hww/makerlisp/docs/bom/ioexp_bom.pdf

IOEXP BOM

Page 1

Designator | Description | Manufacturer | Manufacturer Part Number | Supplier Supplier Part Number | Quantity
| CONN JUMPER SHORTING GOLD FLASH | | SPC02SYAN | S9001-ND | 2
C13 | CAP CER 1UF 16V X7R 0603 | | CL10B105MO8NNWC | 1276-6524-1-ND | 1
C1,C5 | CAP CER 0.1UF 16V Y5V 0603 | | CL10F104ZO8NNNC | 1276-1258-1-ND | 2
C2,C4 | CAP CER 10UF 16V X5R 0805 | | CL21A106KOFNNNE | 1276-2893-1-ND | 2
C3 | CAP CER 0.33UF 35V X5R 0603 | TDK Corporation | CGA3E3X5R1V334M080AB | 445-12479-1-ND | 1
CN1 | CONN HEADER 120POS W/POST SMD | | FX10A-120S/12-SV1(71) | H11234-ND | 1
D1 | LED RED CLEAR CHIP SMD | Lite-On Inc. | LTST-C193KRKT-5A | 160-1830-1-ND | 1
D2 | LED BLUE CLEAR CHIP SMD | Lite-On Inc. | LTST-C193TBKT-5A | 160-1827-1-ND | 1
IC1 | IC INVERTER 1CH 1-INP SC70-5 | Texas Instruments | SN74LVC1G04DCKR | 296-11600-1-ND | 1
J8,J10 | CONN HEADER .100 SNGL STR 16POS | | PREC016SAAN-RC | S1012EC-16-ND | 2
J1-J2,J6-J7 | CONN HEADER .100 SNGL STR 2POS | | PREC002SAAN-RC | S1012EC-02-ND | 4
J3-J4 | CONN HEADER .100 SNGL STR 3POS | | PREC003SAAN-RC | S1012EC-03-ND | 2
J5 | CONN PWR JACK 2X5.5MM SOLDER | CUI Inc. | PJ-002AH-SMT-TR | CP-002AHPJCT-ND | 1
J9 | DIL VERTICAL PC TAIL PIN HEADER | | M20-9980346 | 952-2121-ND | 1
R5-R6,R8,R10 RES SMD 10K OHM 5% 1/4W 0603 | ESR03EZPJ103 | RHM10KDCT-ND | 4
R1,R3-R4,R9 | RES SMD 1K OHM 5% 1/4W 0603 | | ESR03EZPJ102 | RHM1.0KDCT-ND | 4
R2 | RES SMD 100K OHM 5% 1/4W 0603 | | ESR03EZPJ104 | RHM100KDCT-ND | 1
U10 | IC PWR SW USB SOT25 | | XC8107AC20MR-G | Mouser 865-XC8107AC20MR-G | 1
U1 | IC REG LIN 5V 1.5A DDPAK/TO263-3 | Texas Instruments | UA7805CKTTR | 296-20796-1-ND | 1
U2 | IC REG LINEAR 3.3V 1A SOT223-3 | Microchip Technology | MCP1826ST-3302E/DB | MCP1826ST-3302E/DBCT-ND | 1
Sullins Connector Solutions | Digi-Key
Samsung Electro-Mechanics | Digi-Key
Samsung Electro-Mechanics | Digi-Key
Samsung Electro-Mechanics | Digi-Key
| Digi-Key
Hirose Electric | Digi-Key
| Digi-Key
| Digi-Key
| Digi-Key
Sullins Connector Solutions | Digi-Key
Sullins Connector Solutions | Digi-Key
Sullins Connector Solutions | Digi-Key
| Digi-Key
Harwin Inc. | Digi-Key
Rohm Semiconductor | Digi-Key
Rohm Semiconductor | Digi-Key
Rohm Semiconductor | Digi-Key
Torex Semiconductor
| Digi-Key
| Digi-Key

IOEXP BOM

Page 2

DNP Comment
