hww/makerlisp/docs/bom/usb_bom.pdf

USB BOM

Page 1

Designator Description | Manufacturer | Manufacturer Part Number | Supplier Supplier Part Number | Quantity
C1,C6-C7 10uF 6.3V 0603 MLCC capacitor | CL10A106MQ8NNNC | 1276-1119-1-ND | 3
C2,C4 | 18pF 0603 MLCC capacitor | | C0603C180K5GACTU | 399-7866-1-ND | 2
C3,C5,C8 0.1uF 6.3V 0603 MLCC capacitor | CL05B104KQ5NNNC | 1276-1511-1-ND | 3
C9 | 1uF 6.3V 0603 MLCC capacitor | | CL10A105KQ8NNNC | 1276-1036-1-ND | 1
D1 | Red LED 1005 metric | Stanley Electric Co | FHR1105P-TR | 404-1211-1-ND | 1
D2 | Amber LED 1005 metric | Stanley Electric Co | FHA1105P-TR | 404-1210-1-ND | 1
J1 | CONN USB RECEPT R/A TYPE A 4POS TE Connectivity AMP Connectors 292303-1 | A31726-ND | 1
J2 | 0.1 header 6 position ICSP | | 61300611121 | 732-5319-ND | 1
J3 | 0.1 header 4 position | | 61300411121 | 732-5317-ND | 1
R1 | 10k 0603 resistor | Panasonic | ERJ-3GEYJ103V | P10KGCT-ND | 1
R2 | 1k 0603 resistor | Panasonic | ERJ-3GEYJ102V | P1.0KGCT-ND | 1
R3 | 330 0603 resistor | Panasonic | ERJ-3GEYJ331V | P330GCT-ND | 1
S1 | Small push-button switch oval | E-Switch | TL3365AF180QG | EG5384CT-ND | 1
U2 | Regulator | Microchip | MCP1700T-3302E/TT | MCP1700T3302ETTCT-ND | 1
U1 | MCU | Microchip | PIC32MM0064GPM028T-I/SS | PIC32MM0064GPM028T-I/SSCT-ND | 1
Y1 | 8 MHz crystal 20ppm 4-SMD | | ABM3B-8.000MHZ-B2-T | 535-9720-1-ND | 1
Samsung Electro-Mechanics | Digi-Key
Kemet | Digi-Key
Samsung Electro-Mechanics | Digi-Key
Samsung Electro-Mechanics | Digi-Key
| Digi-Key
| Digi-Key
| Digi-Key
Wurth Electronics Inc. | Digi-Key
Wurth Electronics Inc. | Digi-Key
| Digi-Key
| Digi-Key
| Digi-Key
| Digi-Key
| Digi-Key
| Digi-Key
Abracon LLC | Digi-Key

USB BOM

Page 2

DNP Comment
