hww/makerlisp/docs/manuals/mlmswref.rtf

MakerLisp Machine Software Reference

This document is not complete. For now it serves to highlight some important differences between MakerLisp and other Lisp dialects, and gives a list of supported forms.

1. The reader

The reader returns a value as soon as a complete expression is acquired. This means, in the read-evaluate-print loop, a delimiting or ending character typed by the user will cause the expression to be returned to the reader, evaluated, and printed, immediately, without the necessity of ending the line explicitly, by entering a carriage return. This may be surprising, at first. Type "()" to see a simple example. But it also means that you can end complex expressions by typing right parentheses until the expression is accepted - when it is accepted, the reader will print a newline and then pass the expression to the evaluator.

There are no strings in MakerLisp, there are only symbols. As in Scheme, symbols have no properties, only a name. In MakerLisp there are no rules about what character strings can be the name of a symbol, but the reader uses conventional cues about what is likely a number, what is a list, and what is a vector, assuming that anything else is a symbol. These cues can be overridden with ' \ ' (escape, or take literally, as a part of a symbol name, the next character), and ' " ' (assume all characters enclosed by the double quotes are to be taken literally as part of a symbol name).

Where one would use a string, which is a constant, in other Lisps, in MakerLisp, a quoted symbol name is used. For example, instead of "This is a string" typed in the REPL , returning the string as the value, type '"This is a symbol", to get that symbol as the value.

To return a symbol with the name "123", type "123". Or "1 unusual symbol". Symbols can have any name, but the reader will make the ordinary guesses it would make in any Lisp, unless you help it out when there are unusual characters (characters that make a symbol name look like a number, list, or a vector).

2. The path, and auto-loading

When the environment is searched for a binding for a variable, if none is found, the evaluator checks to see if, somewhere on the path, there is a file named "< symbol name>.l" . If no such file is found, the symbol is unbound and an error is thrown. If a file is found, a stub macro is put in place as the value of the variable. This stub assumes that the symbol is being used as a function or macro name in the first position of an application, and causes that specific file to be loaded, every expression in the file to be evaluated, and then the original application is re-evaluated, this time with the benefit of the re-binding of the symbol according to the loaded file. If the file did in fact define the value of the symbol to be a well-formed function or macro, then execution proceeds as if the symbol had been defined that way before it was used in an application. So it is not neccessary to include or load function or macro definitions before those functions or macros are used, if a properly named file with the function or macro definition is on the path. For example, "demo/hello.l" is in the default filesystem image, and the default path is "/demo:/bin". So typing "(hello)" executes the function defined in "demo/hello.l".

The path exists in two parts: there is a path variable "*PATH*", and as shown above, it contains directory specifications, separated by colons. These directories are searched first. You can set the *PATH* variable to anything you like.

The other part of the path is searched next, and it is not specified by any Lisp variable, it is hard-wired in the MakerLisp system. This built-in set of searched directories are the subdirectories of the "/l" directory. They contain essential language definitions and utility functions.

When the system starts up, it starts by loading "/l/util/makerlisp.l". The last expression in this includes the "/l/user.l" file. user.l defines the *PATH* variable, and prints a start-up message. If you want to change your path, or add to your start-up, this is a good place to do that.

3. List of supported forms

In the following list, for each function, the diectory in which the defining lisp file is given, or if the form is defined by the implementation, "core" is displayed. In the notes column, a brief comment is given if the form is unlike anything in Scheme or Common Lisp.

Form Defined In Notes

call/cc core
define core
if core
lambda core
macro core
progn core
quote core
setq core

_add core dyadic add
_cats core dyadic symbol concatenation
_div core dyadic divide
_equal core dyadic equal
_iand core dyadic integer (bitwise) and
_ior core dyadic integer (bitwise) or
_ixor core dyadic integer (bitwise) exclusive or
_less core dyadic less-than
_mul core dyadic multiply
_sub core dyadic subtract
% core integer modulus
assignedp core
boundp core
car core
cd core change directory
cdr core
commitid core flash rom signature
cons core
debugger core low-level debugger
defer core defer (^C) breaks
eof core skip to end of file in input stream
eq core
orerror core throw an error
eval
forget core forget (unbind) top-level variable
gensym core
ffcall core foreign function call
inclevel core current input stream include level
include core include a file in input stream
int2real core convert integer to real
int2sym core convert integer to 1 character symbol
integerp core
keyp core keypress at UART 0/TTY
list core
list2vector core convert list to vector
ls core current directory listing
not core
pairp core
print core
quit core stop, show statistics
read core
readreg core read I/O register
real2int core convert real to integer
realp core
rplaca core
rplacd core
setetop core get rest after/truncate-to mark in env
sym2int core convert symbol first character to integer
symbolp core
vectorp core
verbose core verbosity (include level display) in REPL
vlen core vector length
vref core vector element reference
vset core vector element store
writereg core write I/O register
zerop core
~ core integer (bitwise) complement
>> core integer arithmetic shift right
<< core integer shift left

atoi l/clib
ceil l/clib
fclose l/clib
fgetc l/clib
floor l/clib
fopen l/clib
fputc l/clib
getchar l/clib
isalpha l/clib
isdigit l/clib
isspace l/clib
pow l/clib
putchar l/clib
rewind l/clib
sprintf l/clib
sqrt l/clib
stderr l/clib
stdin l/clib
stdio l/clib
stdout l/clib
toupper l/clib
ungetc l/clib

FLASH_COL l/ez80 eZ80 I/O and GPIO register access
FLASH_DATA l/ez80
FLASH_FDIV l/ez80
FLASH_KEY l/ez80
FLASH_PAGE l/ez80
FLASH_PGCTL l/ez80
FLASH_PROT l/ez80
FLASH_ROW l/ez80
gpin l/ez80
gpout l/ez80
PA_ALT1 l/ez80
PA_ALT2 l/ez80
PA_DDR l/ez80
PA_DR l/ez80
PB_ALT1 l/ez80
PB_ALT2 l/ez80
PB_DDR l/ez80
PB_DR l/ez80
PC_ALT1 l/ez80
PC_ALT2 l/ez80
PC_DDR l/ez80
PC_DR l/ez80
PD_ALT1 l/ez80
PD_ALT2 l/ez80
PD_DDR l/ez80
PD_DR l/ez80
regbclr l/ez80
regbset l/ez80
RTC_CEN l/ez80
RTC_CTRL l/ez80
RTC_DOM l/ez80
RTC_DOW l/ez80
RTC_HRS l/ez80
RTC_MIN l/ez80
RTC_MON l/ez80
RTC_SEC l/ez80
RTC_YR l/ez80

add l/lang variadic add
and l/lang variadic logical and
append l/lang
apply l/lang
arithmetc l/lang (+,-,*,/, etc.)
assoc l/lang
assq l/lang
atom l/lang
backquote l/lang quasiquote
caaaar l/lang
caaadr l/lang
caaar l/lang
caadar l/lang
caaddr l/lang
caadr l/lang
caar l/lang
cadaar l/lang
cadadr l/lang
cadar l/lang
caddar l/lang
cadddr l/lang
caddr l/lang
cadr l/lang
case l/lang
cats l/lang variablic symbol concatenation
cdaaar l/lang
cdaadr l/lang
cdaar l/lang
cdadar l/lang
cdaddr l/lang
cdadr l/lang
cdar l/lang
cddaar l/lang
cddadr l/lang
cddar l/lang
cdddar l/lang
cddddr l/lang
cdddr l/lang
cddr l/lang
cond l/lang
constant l/lang make constant from expression
div l/lang variadic divide
eql l/lang
equal l/lang
for l/lang
global l/lang bind in top environment
_greater l/lang dyadic greater-than
greater l/lang variadic greater-than
_greaterorequal
l/lang dyadic greater-than or equal
greaterorequal
l/lang variadic greater-than or equal
iand l/lang variadic integer (bitwise) and
ior l/lang variadic integer (bitwise) and
ixor l/lang variadic integer (bitwise) exclusive or
_land l/lang dyadic logical and
length l/lang
less l/lang variadic less-than
_lessorequal
l/lang dyadic less-than or equal
lessorequal l/lang variadic less-than or equal
let l/lang
lets l/lang let-sequential (let*)
listp l/lang
_lor l/lang dyadic logical or
mul l/lang variadic multiply
n-ary l/lang supports variadic functions
nlprint l/lang print, follow with newline
nth l/lang
null l/lang
numberp l/lang true if real or integer
order-nary l/lang supports variadic functions
or l/lang variadic logical or
reverse l/lang
sub l/lang variadic subtract
switch l/lang C-like switch
vector2list l/lang convert vector to list
vector l/lang
while l/lang C-like while

author l/util Show author name and address
debug l/util debug function
discard l/util Swallow expression, return "" symbol
expand l/util Show expression with all macros expanded
import l/util Create load/apply stub for symbol
load l/util load file, evaluate all expressions
makerlisp l/util System start-up
nopatch l/util Turn off JIT and macro patching
patchon l/util Restore JIT and macro patching
repl l/util second-level REPL
trace l/util trace function or macro
undebug l/util Turn off debugger break on function
untrace l/util Turn off trace of function or macro
user l/util User start-up
version l/util Software version
