hww/makerlisp/docs/manuals/mlmterm.rtf

MakerLisp Machine VGA Display Terminal Emulation

I. Overview

The MakerLisp Machine terminal emulates a compatible subset of the DEC vt5xx (vt510, vt520, or vt525) series of ANSI terminals, operating in SCO Unix Console emulation mode, with newline mode on.

There are two parts to the MakerLisp VGA terminal - the USB keyboard controller, and the VGA display controller.

The USB keyboard controller sends out ASCII character sequences from keyboard activity, like the DEC vt5xx terminals in SCO/newline mode, except that:

1) The "Alt" modifier key is ignored
2) "Ctrl" in combination with shifted or unshifted F1-F12, has no effect
3) The editing keys (except for forward delete), Prnt Scrn, Scroll Lock, and Pause/Break, have no effect.

These key events will be supported in a future release.

The VGA display controller's terminal emulator uses X-ON/X-OFF flow control, to keep the MakerLisp Machine CPU from overrunning the terminal emulator's 256 character buffer. This flow control is on all the time.

II. ANSI Terminal Emulator

The terminal emulator supports a very small subset of vt5xx ANSI escape sequence commands, listed below, as well as a few other ANSI-like, but specific to the MakerLisp Machine, escape sequences. Some of the MakerLisp-specific commands have different effects in different display modes (see section III below).

A more capable subset of vt5xx-compatible escape sequences will be implemented in a future release.

vt5xx-compatible ANSI commands ('\e' is "escape", ASCII 27 decimal):

\e[2J Clear screen
\e[p1;p2H Position or home cursor

p1 is a line number from 1 to the number of lines in the display, p2 is a column number from 1 to the number of columns in the display. If p1 and p2 are not both provided then the cursor is 'homed' to row 1, column 1. A value of zero in either p1 or p2 is interpreted as a value of 1.

\e[p1A Cursor up
\e[p1B Cursor down
\e[p1C Cursor forward
\e[p1D Cursor backward

p1 is a number of positions to move the cursor, if this parameter is not provided, these comands will move the cursor by one position.

\e[p1;p2; ... pn;m Set Graphics Rendition

p1 ... pn are ASCII decimal numbers, they are separated by semicolons before the 'm' which defines the 'Set Graphics Rendition' command. If no parameters are given, a single parameter of 0 is assumed. The parameters supported are:

0 : Reset to default attributes
1 : Set bright intensity attribute
7 : Set reverse video attribute
22 : Set normal intensity attribute
27 : Set normal (not reverse) video attribute
30 - 37 : Set foregound color 0 - 7
39 : Set default foreground color
40 - 47: Set background color 0 - 7
49 : Set default background color

With these SGR command parameters, it is possible to set all 16 foreground colors (0-7, 8-15 are 'bright' versions of 0-7), all 8 background colors, and the reverse video attribute, with an ANSI compatible command.

\e[20h Enable newline mode
\e[20l Disable newline mode
\e[?25h Enable cursor display
\e[?25l Disable cursor display
\e[?7h Enable auto line-wrap
\e[?7l Disable auto line-wrap

MakerLisp VGA terminal-specific commands:

\ec Insert literal character

'c' is a character to be inserted literally at the cursor position. If 'c' is a character
that would otherwise have terminal control functions, in this instance it will not, the character will be inserted into the display buffer, allowing the code page 437 character cell defined for that value to be displayed. The cursor position is unchanged, it does not automatically advance with this command.

\e[[ Insert literal character '['

Like the \ec command above, to insert the character '['

\e[p1;p2;p3;p4R Keyboard and Display ROM read/write
\e[p1;p2U
\e[p1;p2;p3;p4;p5;p6V
\e[p1;p2;p3;p4;p5;p6;p7;p8W

These commands are used by utilities to read and write the contents of the keyboard controller's flash memory, or the display controller's EEPROM.

\e[X<f><b> Set foreground / background colors

720x480 display mode:

<f> and <b> are binary bytes, the low four bits of <f> are the foreground color index, and the low three bits of <b> are the background color index. The background color is limited to the 8 normal intensity, not 'bright' colors, in the 16 color ANSI palette.

640x480 or 1024x768 display modes:

<f> and <b> are binary bytes, the low four bits of <f> are the foreground color index, and the low four bits of <b> are the background color index, the background color may be a normal intensity or a bright color in the 16 color ANSI palette.

In any display mode, if BOTH <f> and <b> are either 0xFF or 0x00, this signifies the default color combination at palette index 0, 0 (loaded at start-up with gold foreground on black background).

720x480 display mode:

\e[Y<f><b><fc><bc> Load color palette

<f> and <b> are binary bytes, the low four bits of <f> are the foreground color index, and the low three bits of <b> are the background color index, <f> and <b> together indicating one of 128 color palette entries. <fc> is a byte which specifies one of 64 color values, the low six bits being a 2:2:2 r,g,b format, and <bc> is the background color value, in the same format.

640x480 or 1024x768 display modes:

\e[Y<fc><bc> Set direct color

<fc> and <bc> are binary bytes, the low six bits being the color in 2:2:2 r,g,b format.

\e[Z<r> Set reverse video attribute

<r> is a binary byte, the low bit indicating normal (0) or reverse (1) video

III. Display Resolution, Character cells, and Colors

The default display resolution, corresponding to the EEPROM image provided in the SD card filsystem, '/etc/vga720.rom', is 720x480, providing 30, 80 column rows, of 9x16, code page 437 "extended ascii" characters. The ANSI terminal commands described above may be used to set the indicated foreground, background color combinations on any character as it is written at the current cursor position.

This is the default display controller mode, and firmware loaded onboard, for the VGA display controller as it is shipped from MakerLisp. Two other optional sets of firmware are also provided on the SD card filesystem, and the VGA firmware update utilities can be used to load new firmware and change the display mode - see HOWTO/update.txt for instructions on how to do this.

The optional modes/firmware images are:

'/etc/vga640.rom'

Display resolution of 640x480, providing 30, 80 column rows of 8x16 code page 437 characters. Colors are set with the same ANSI commands as in 720x480 mode, but there are some differences, noted above, and when a color combination is set, it applies to the whole row corresponding to the current cursor position. This mode has slightly larger characters and runs at a lower refresh rate, and it may be more usable on some monitors that have trouble with the default 720x480 mode.

'/etc/vga1024.rom'

Colors set as in 640x480 mode, as noted in descriptions of ANSI commands, above. Display resolution of 1024x768, providing 48, 128 column rows of 8x16 code page 437 characters. This mode may be useful for larger monitors, when a larger text display is desired.
