hww/makerlisp/docs/schematic/cpu_sch.pdf

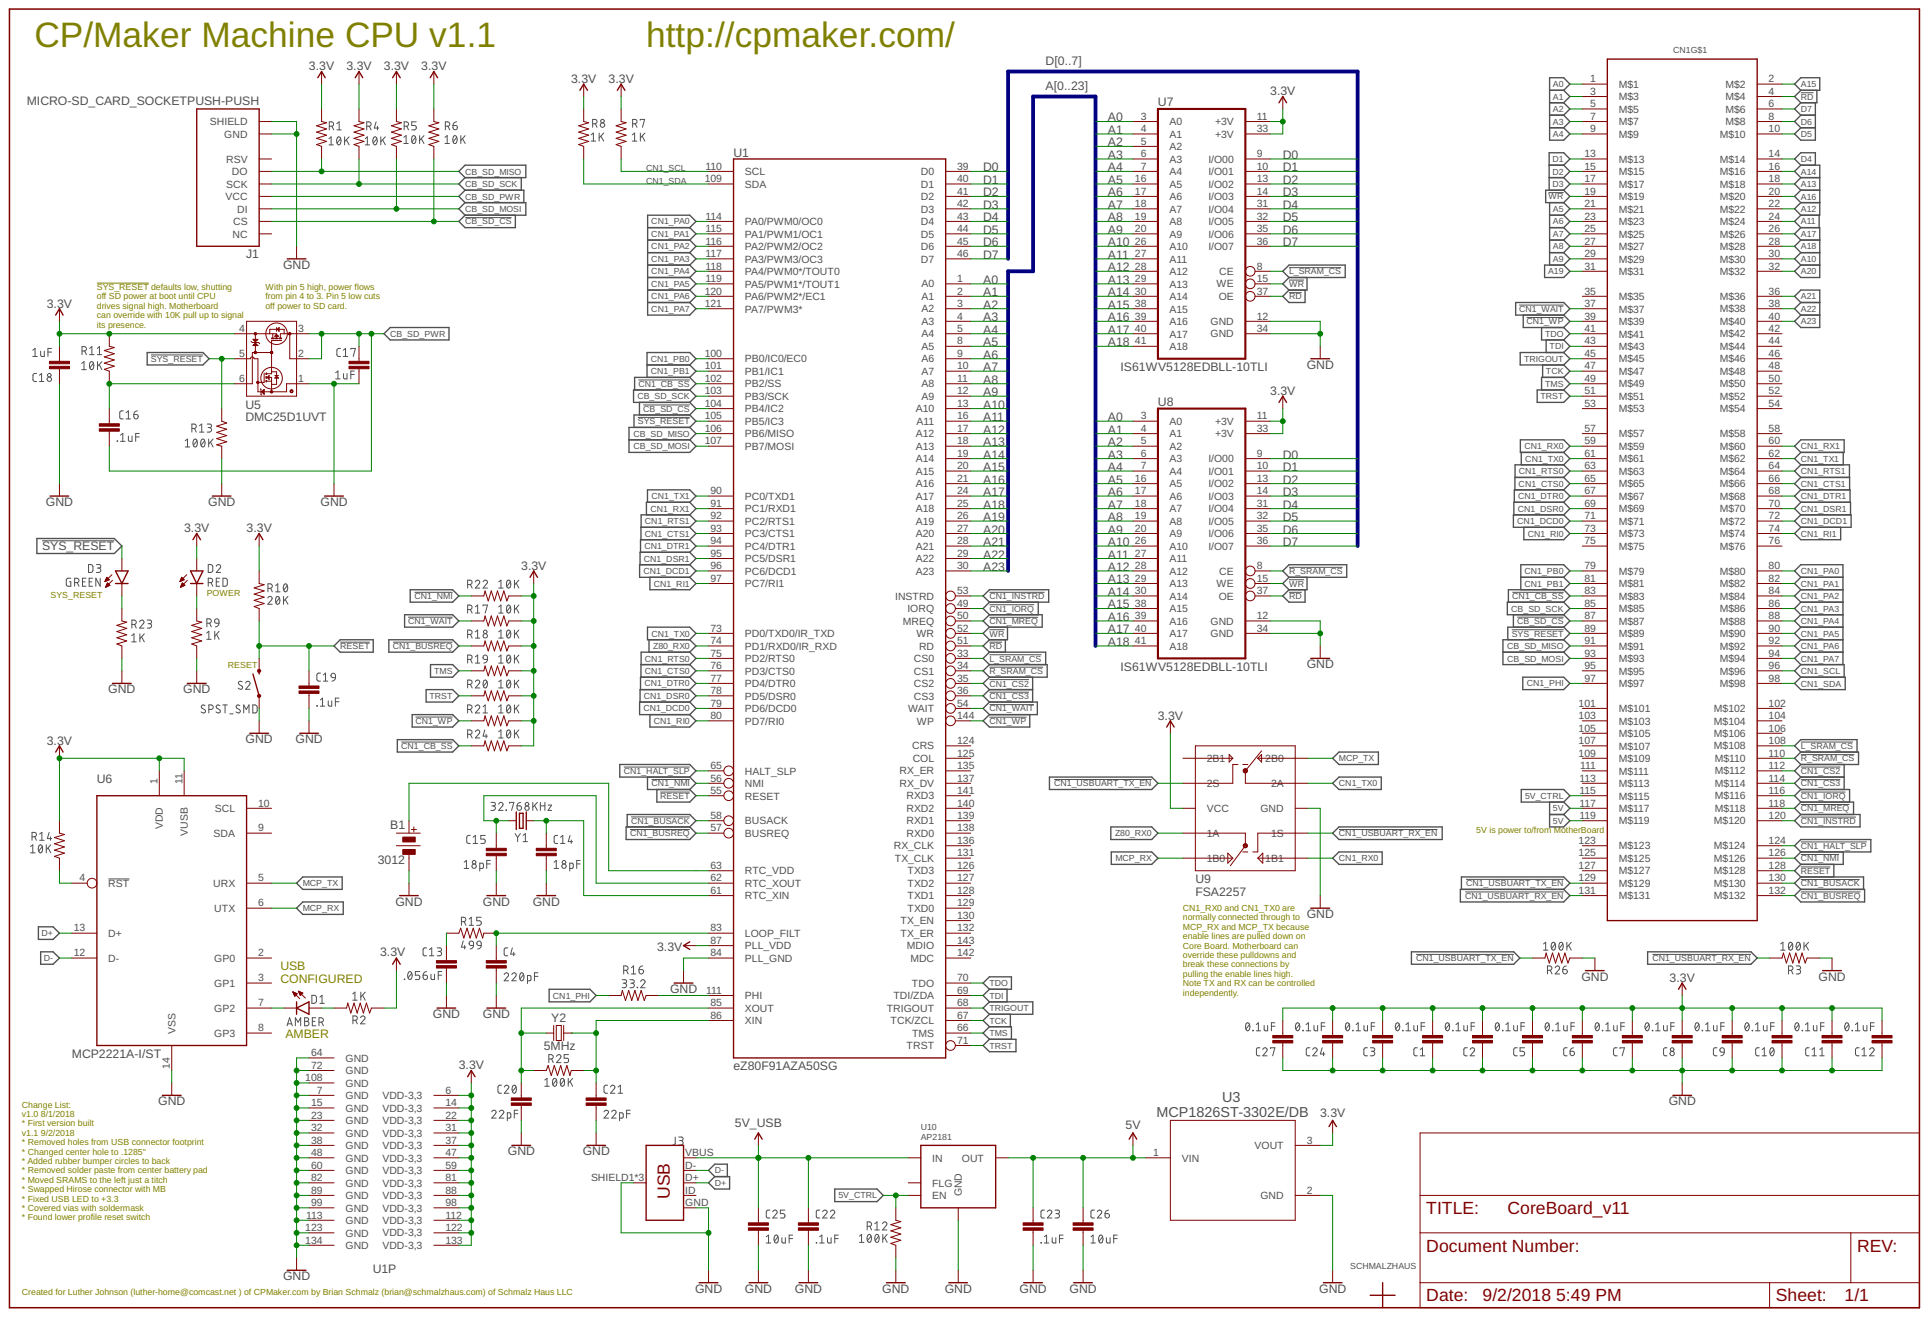
[picture p4: page 1]

CP/Maker Machine CPU v1.1

SYS_RESET defaults low, shutting
off SD power at boot until CPU
drives signal high. Motherboard
can override with 10K pull up to signal

from pin 4 to 3. Pin 5 low cuts off power to SD card.

CN1_CB_SS CB_SD_SCK | 11 A9 12 A10 A9

5V is power to/from MotherBoard CN1_RX0 and CN1_TX0 are

normally connected through to MCP_RX and MCP_TX because

enable lines are pulled down on Core Board. Motherboard can

override these pulldowns and
break these connections by pulling the enable lines high. Note TX and RX can be controlled

5V_USB
D+ D- VBUS GND
REV: TITLE: Document Number: CoreBoard_v11 USB

* Removed holes from USB connector footprint * Changed center hole to .1285" * Added rubber bumper circles to back

* Removed solder paste from center battery pad
* Moved SRAMS to the left just a titch
* Swapped Hirose connector with MB
* Fixed USB LED to +3.3
* Covered vias with soldermask
* Found lower profile reset switch Created for Luther Johnson (luther-home@comcast.net ) of CPMaker.com by Brian Schmalz (brian@schmalzhaus.com) of Schmalz Haus LLC
