hww/makerlisp/docs/schematic/ioexp_sch.pdf

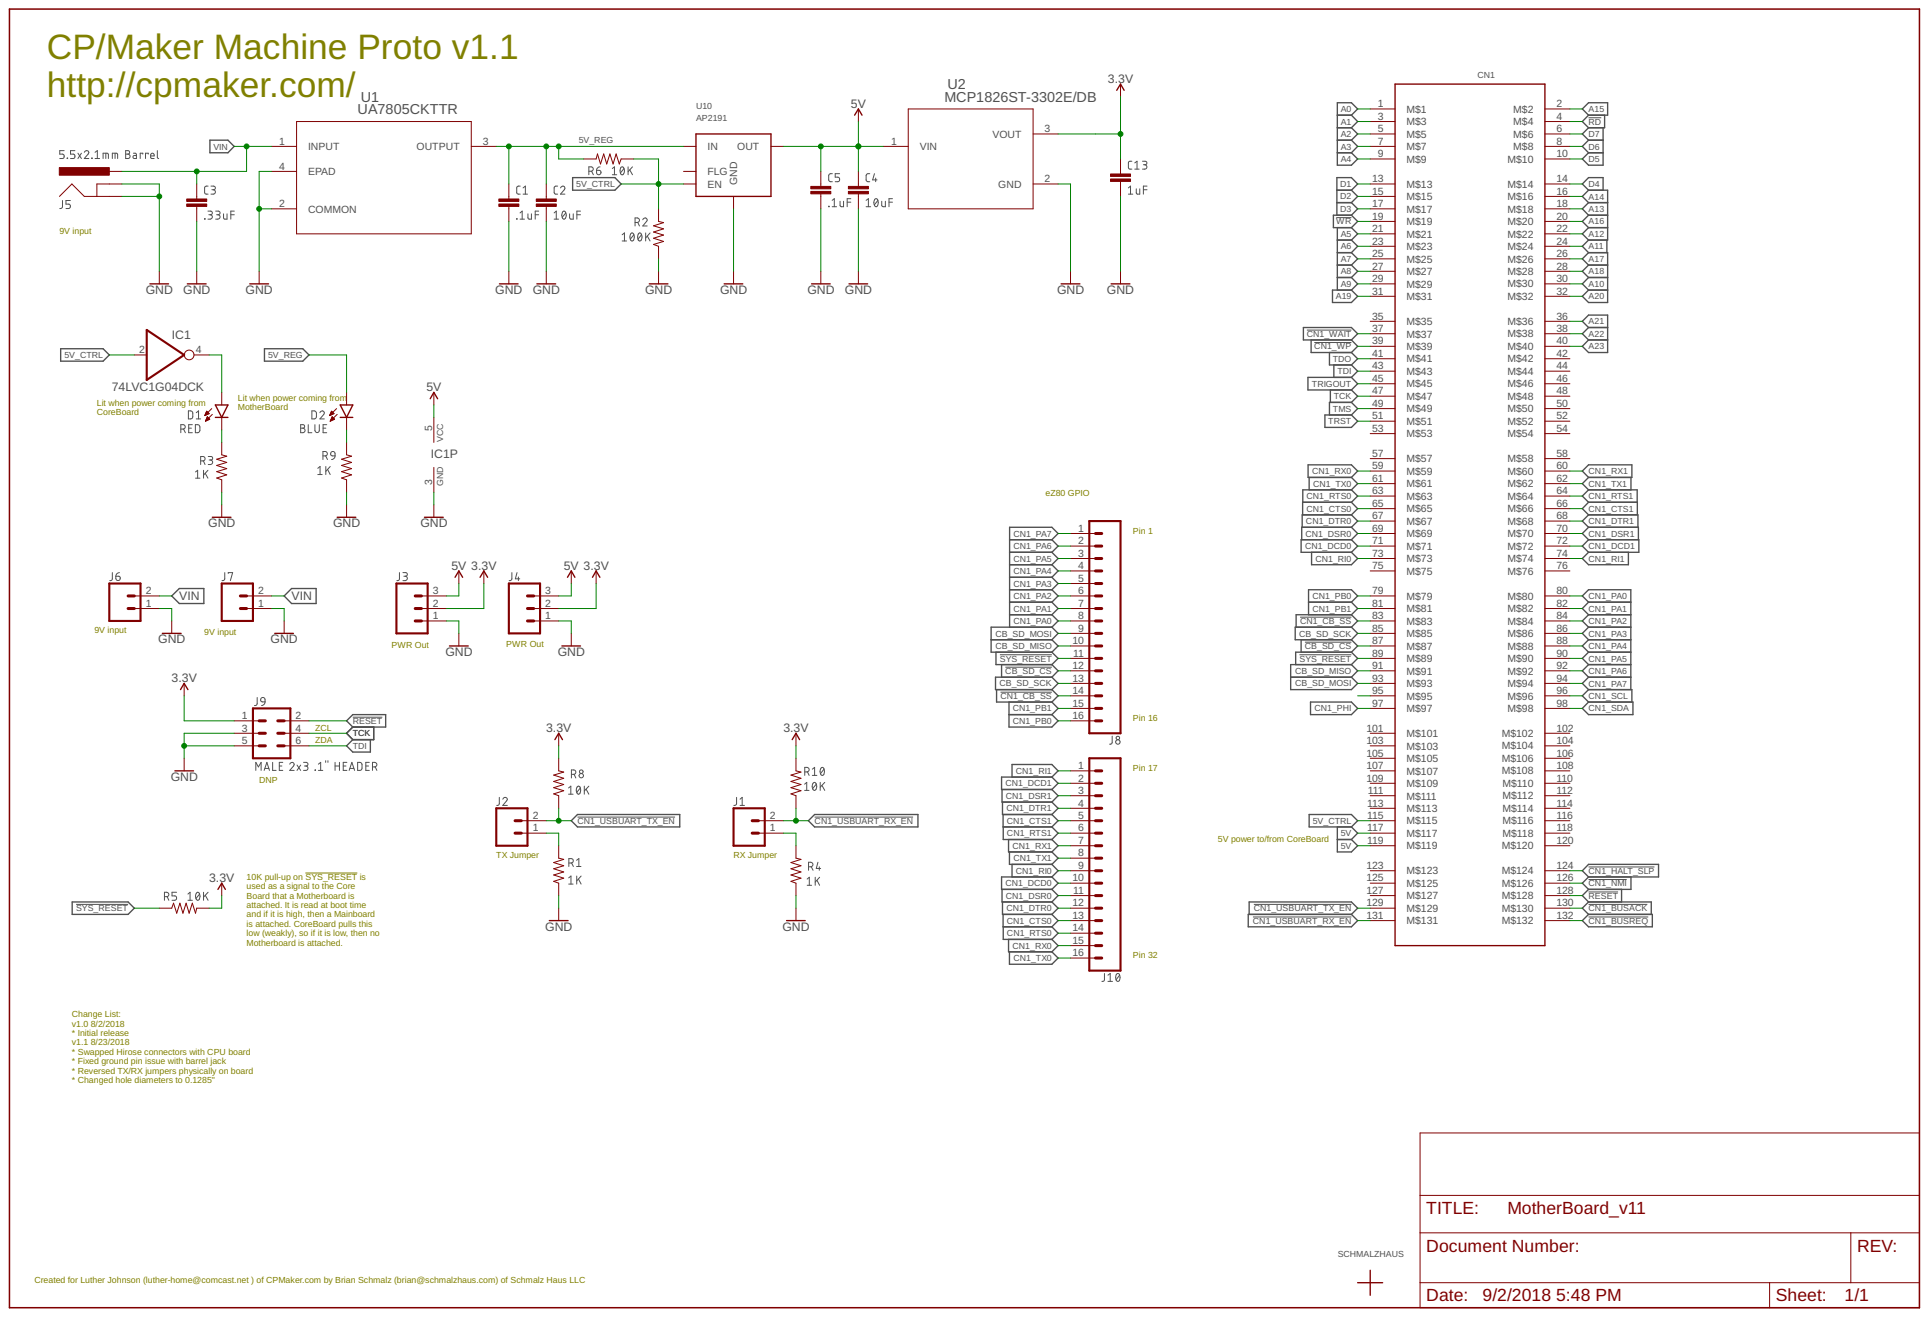
[picture p5: page 1]

CP/Maker Machine Proto v1.1
http://cpmaker.com/

Lit when power coming from
CoreBoard

MotherBoard

5 | TCK 6

5V power to/from CoreBoard

10K pull-up on SYS_RESET is used as a signal to the Core Board that a Motherboard is attached. It is read at boot time

and if it is high, then a Mainboard
is attached. CoreBoard pulls this
low (weakly), so if it is low, then no Motherboard is attached.

* Initial release
* Swapped Hirose connectors with CPU board
* Fixed ground pin issue with barrel jack
* Reversed TX/RX jumpers physically on board
* Changed hole diameters to 0.1285"

REV: TITLE: Document Number: MotherBoard_v11

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

Date: 9/2/2018 5:48 PM | Sheet: 1/1
