hww/makerlisp/docs/schematic/usb_sch.pdf

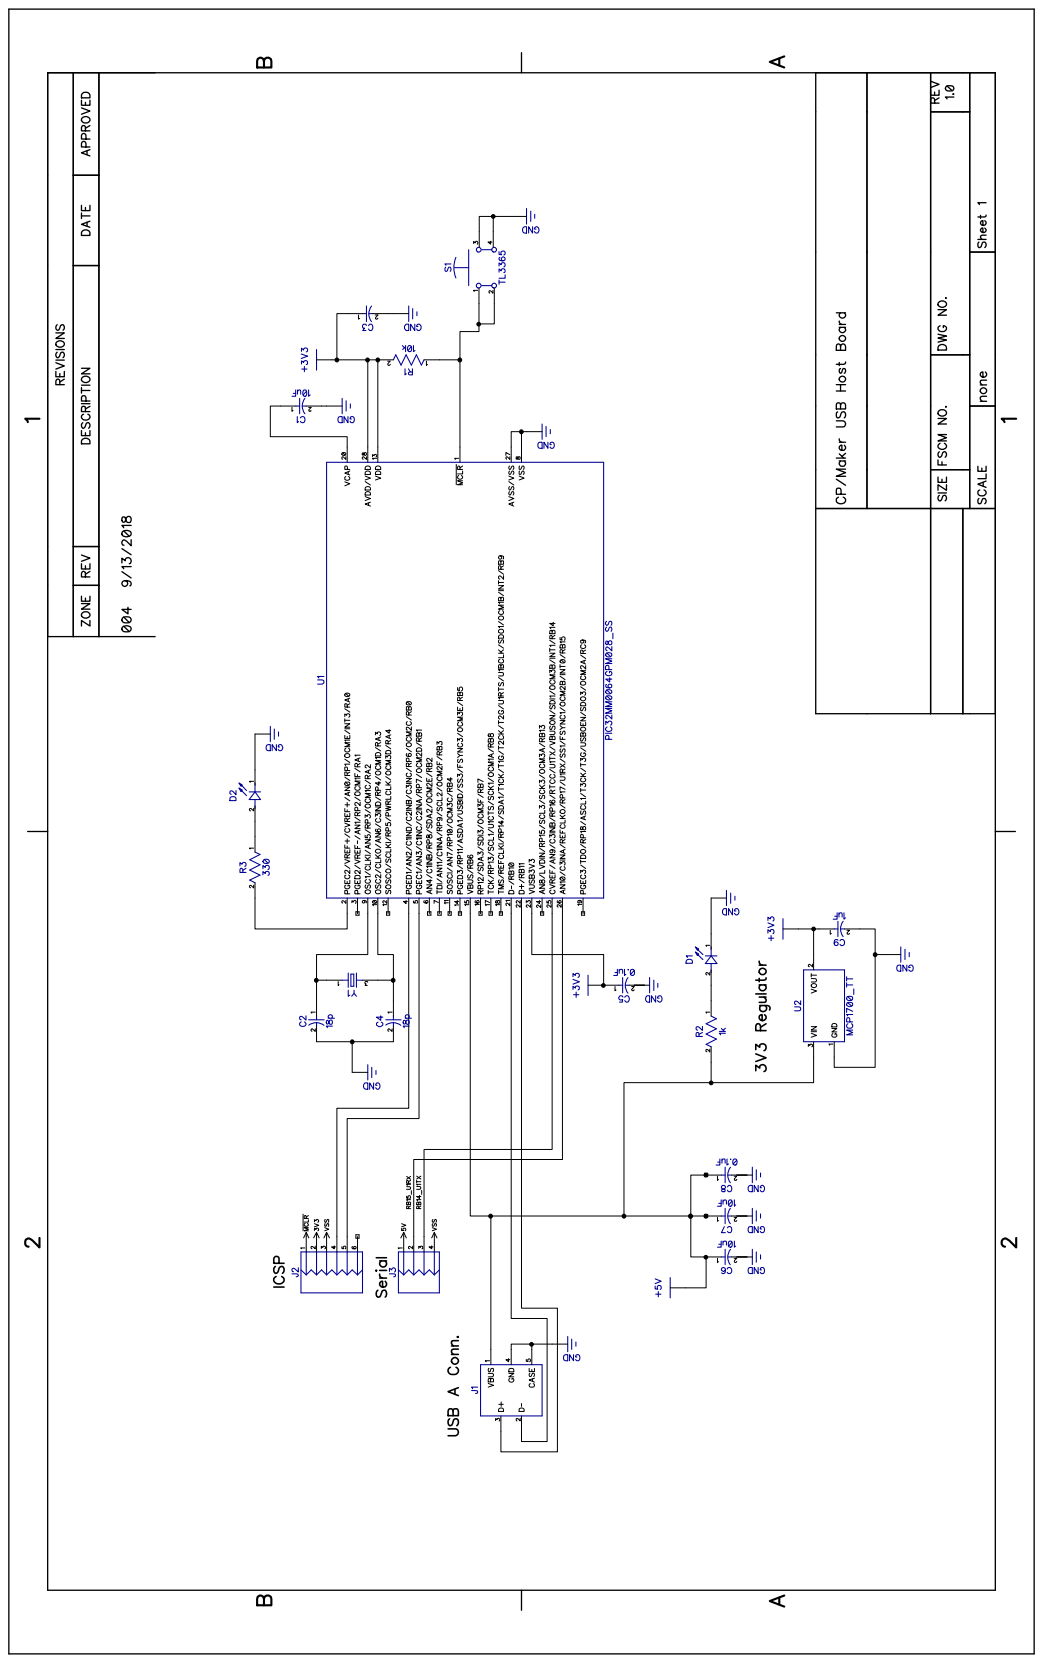
[picture p6: page 1]
