hww/makerlisp/docs/schematic/vga_sch.pdf

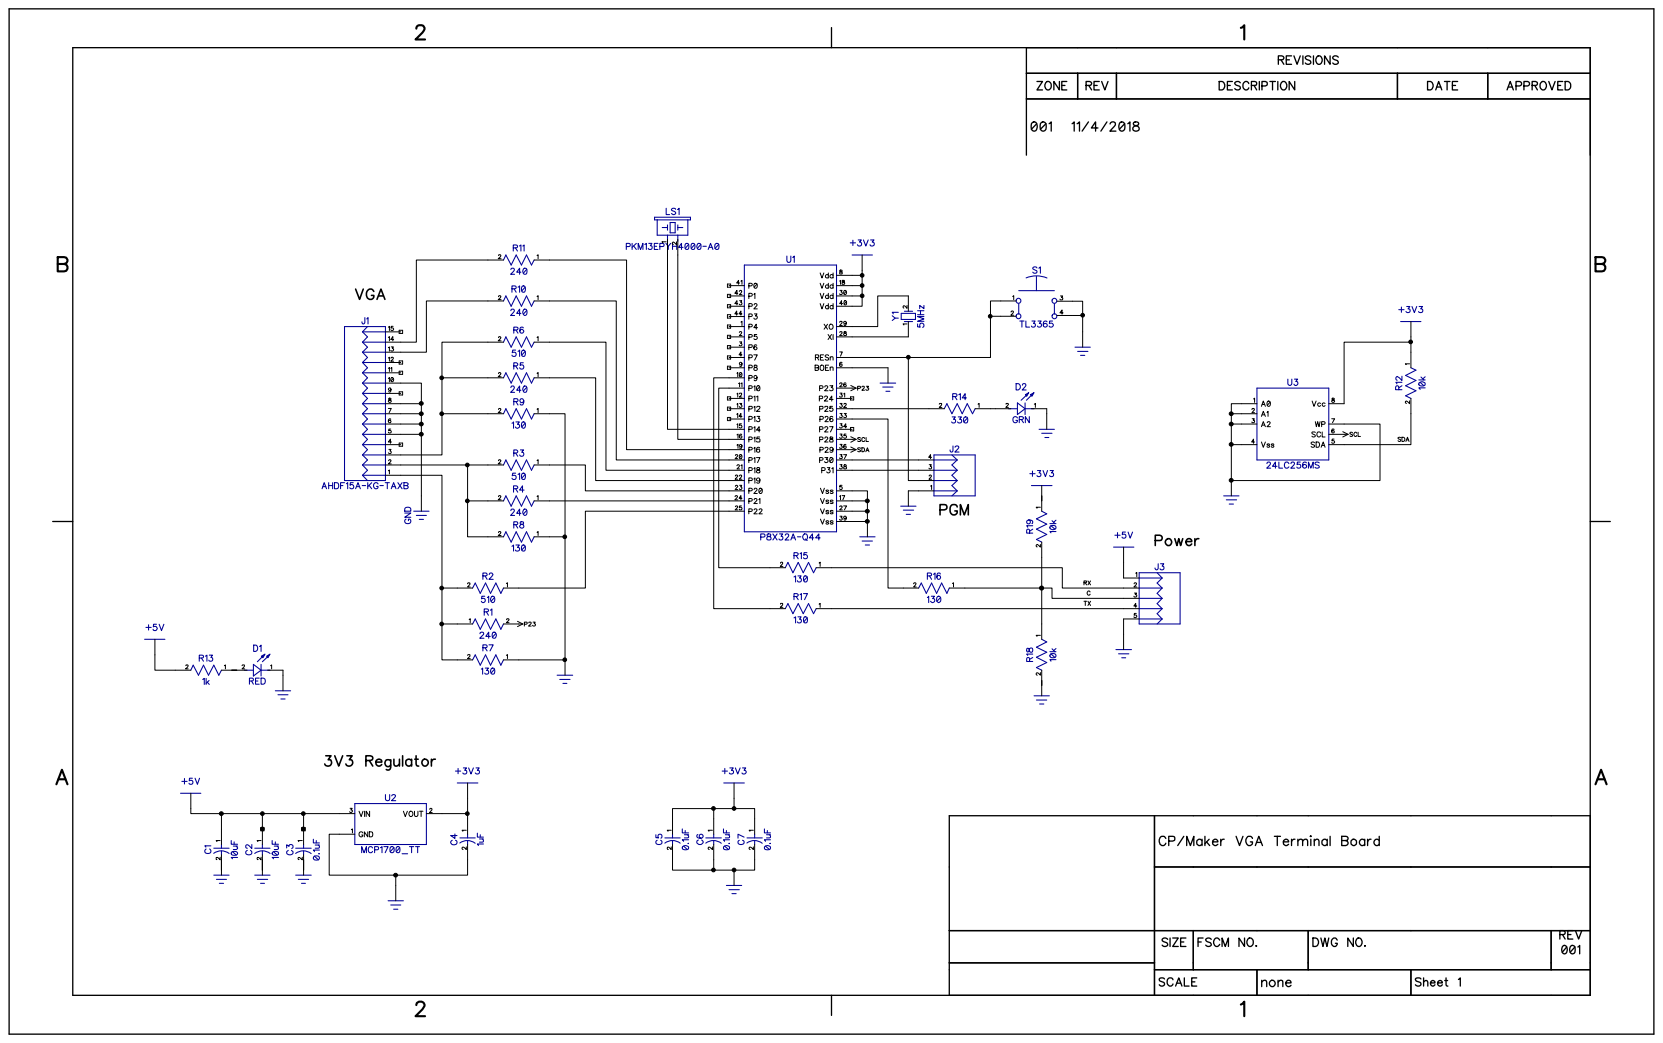
[picture p7: page 1]
