hww/makerlisp/src/cpm/isrwrap.asm

; --------------------------------------------------------------------------
; Copyright (c) 2019, Christopher D. Farrar
; --------------------------------------------------------------------------
; I here grant permission to any and all to copy and use this software for
; any purpose as long as my copyright message is retained.
; --------------------------------------------------------------------------

; --------------------------------------------------------------------------
; Boot and warm boot functions
; --------------------------------------------------------------------------
                TITLE   "Interrupt service routine wrappers"
; --------------------------------------------------------------------------

; --------------------------------------------------------------------------
; some basic init stuff
; --------------------------------------------------------------------------
                CPU = EZ80F91

                segment         CODE
                .assume         adl=1
; --------------------------------------------------------------------------

; --------------------------------------------------------------------------
; external references to the isr routines being wrapped
; --------------------------------------------------------------------------
                xref            _isr_uart0
                xref            _isr_uart1
; --------------------------------------------------------------------------

; --------------------------------------------------------------------------
; defines for external access to interrupt wrappers
; --------------------------------------------------------------------------
                xdef            _isruart0
                xdef            _isruart1
; --------------------------------------------------------------------------

; --------------------------------------------------------------------------
; wrapper functions
; --------------------------------------------------------------------------
_isruart0:      push            af
                push            bc
                push            de
                push            hl
                push            ix
                push            iy
                ex              af,af'
                exx
                push            af
                push            bc
                push            de
                push            hl
                call            _isr_uart0
                pop             hl
                pop             de
                pop             bc
                pop             af
                exx
                ex              af,af'
                pop             iy
                pop             ix
                pop             hl
                pop             de
                pop             bc
                pop             af
                ei
                reti.l
; --------------------------------------------------------------------------
_isruart1:      push            af
                push            bc
                push            de
                push            hl
                push            ix
                push            iy
                ex              af,af'
                exx
                push            af
                push            bc
                push            de
                push            hl
                call            _isr_uart1
                pop             hl
                pop             de
                pop             bc
                pop             af
                exx
                ex              af,af'
                pop             iy
                pop             ix
                pop             hl
                pop             de
                pop             bc
                pop             af
                ei
                reti.l
; --------------------------------------------------------------------------

; --------------------------------------------------------------------------
                end
; --------------------------------------------------------------------------
