hww/makerlisp/src/usbkey/mla_v2017_03_06/bsp/exp16/pic32mm0256gpm064_pim/uart1.h

/**
  UART1 Generated Driver API Header File

  @Company
    Microchip Technology Inc.

  @File Name
    uart1.h

  @Summary
    This is the generated header file for the UART1 driver using PIC24 / dsPIC33 / PIC32MM MCUs

  @Description
    This header file provides APIs for driver for UART1.
    Generation Information :
        Product Revision  :  PIC24 / dsPIC33 / PIC32MM MCUs - pic24-dspic-pic32mm : 1.53.0.1
        Device            :  PIC32MM0256GPM064
    The generated drivers are tested against the following:
        Compiler          :  XC32 v1.44
        MPLAB             :  MPLAB X v4.05
*/

/*
    (c) 2016 Microchip Technology Inc. and its subsidiaries. You may use this
    software and any derivatives exclusively with Microchip products.

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
    IN NO EVENT WILL MICROCHIP BE LIABLE FOR ANY INDIRECT, SPECIAL, PUNITIVE,
    INCIDENTAL OR CONSEQUENTIAL LOSS, DAMAGE, COST OR EXPENSE OF ANY KIND
    WHATSOEVER RELATED TO THE SOFTWARE, HOWEVER CAUSED, EVEN IF MICROCHIP HAS
    BEEN ADVISED OF THE POSSIBILITY OR THE DAMAGES ARE FORESEEABLE. TO THE
    FULLEST EXTENT ALLOWED BY LAW, MICROCHIP'S TOTAL LIABILITY ON ALL CLAIMS IN
    ANY WAY RELATED TO THIS SOFTWARE WILL NOT EXCEED THE AMOUNT OF FEES, IF ANY,
    THAT YOU HAVE PAID DIRECTLY TO MICROCHIP FOR THIS SOFTWARE.

    MICROCHIP PROVIDES THIS SOFTWARE CONDITIONALLY UPON YOUR ACCEPTANCE OF THESE
    TERMS.
*/

#ifndef _UART1_H
#define _UART1_H

#include <xc.h>
#include <stdbool.h>
#include <stdint.h>

/** UART1 Driver Hardware Flags

  @Summary
    Specifies the status of the hardware receive or transmit

  @Description
    This type specifies the status of the hardware receive or transmit.
    More than one of these values may be OR'd together to create a complete
    status value.  To test a value of this type, the bit of interest must be
    AND'ed with value and checked to see if the result is non-zero.
*/
typedef enum
{
    /* Indicates that Receive buffer has data, at least one more character can be read */
    UART1_RX_DATA_AVAILABLE
        /*DOM-IGNORE-BEGIN*/  = (1 << 0) /*DOM-IGNORE-END*/,
    
    /* Indicates that Receive buffer has overflowed */
    UART1_RX_OVERRUN_ERROR
        /*DOM-IGNORE-BEGIN*/  = (1 << 1) /*DOM-IGNORE-END*/,

    /* Indicates that Framing error has been detected for the current character */
    UART1_FRAMING_ERROR
        /*DOM-IGNORE-BEGIN*/  = (1 << 2) /*DOM-IGNORE-END*/,

    /* Indicates that Parity error has been detected for the current character */
    UART1_PARITY_ERROR
        /*DOM-IGNORE-BEGIN*/  = (1 << 3) /*DOM-IGNORE-END*/,

    /* Indicates that Receiver is Idle */
    UART1_RECEIVER_IDLE
        /*DOM-IGNORE-BEGIN*/  = (1 << 4) /*DOM-IGNORE-END*/,

    /* Indicates that the last transmission has completed */
    UART1_TX_COMPLETE
        /*DOM-IGNORE-BEGIN*/  = (1 << 8) /*DOM-IGNORE-END*/,

    /* Indicates that Transmit buffer is full */
    UART1_TX_FULL
        /*DOM-IGNORE-BEGIN*/  = (1 << 9) /*DOM-IGNORE-END*/

} UART1_STATUS;

/* Characters in UART1 receive queue */
#define UART1_CharReady UART1_DataReady
int UART1_DataReady();

/**
  @Summary
    Initialization routine that takes inputs from the UART1 GUI.

  @Description
    This routine initializes the UART1 driver.
    This routine must be called before any other UART1 routine is called.

  @Preconditions
    None

  @Param
    None

  @Returns
    None

  @Comment
    
*/
void UART1_Initialize(void);

/**
  @Summary
    Read a byte of data from the UART1.

  @Description
    This routine reads a byte of data from the UART1.

  @Preconditions
    UART1_Initialize() function should have been called
    before calling this function. This is a blocking function.
    So the recieve status should be checked to see
    if the receiver is not empty before calling this function.

  @Param
    None

  @Returns
    A data byte received by the driver.
*/
uint8_t UART1_Read(void);

 /**
  @Summary
    Writes a byte of data to the UART1.

  @Description
    This routine writes a byte of data to the UART1.

  @Preconditions
    UART1_Initialize() function should have been called
    before calling this function. The transfer status should be checked to see
    if transmitter is not busy before calling this function.

  @Param
    txData  - Data byte to write to the UART1

  @Returns
    None
*/
void UART1_Write(uint8_t txData);

/**
  @Summary
    Returns the transmitter and receiver status

  @Description
    This returns the transmitter and receiver status. The returned status may 
    contain a value with more than one of the bits
    specified in the UART1_STATUS enumeration set.  
    The caller should perform an "AND" with the bit of interest and verify if the
    result is non-zero (as shown in the example) to verify the desired status
    bit.

  @Preconditions
    UART1_Initializer function should have been called 
    before calling this function

  @Param
    None.

  @Returns
    A UART1_STATUS value describing the current status 
    of the transfer.

  @Example
    <code>
        while(!(UART1_StatusGet & UART1_TX_COMPLETE ))
        {
           // Wait for the tranmission to complete
        }
    </code>
*/

UART1_STATUS UART1_StatusGet (void );

#endif  // _UART1_H
