hww/makerlisp/src/cpm/ascii.h

//----------------------------------------------------------------------------
// Copyright (c) 2019, Christopher D. Farrar
//----------------------------------------------------------------------------
// I here grant permission to any and all to copy and use this software for
// any purpose as long as my copyright message is retained.
//----------------------------------------------------------------------------
#ifndef ASCII_H
#define ASCII_H
//----------------------------------------------------------------------------
#define ASCII_SOH       (0x01)
#define ASCII_ETX       (0x03)
#define ASCII_EOT       (0x04)
#define ASCII_BELL      (0x07)
#define ASCII_BACKSPACE (0x08)
#define ASCII_TAB       (0x09)
#define ASCII_LINEFEED  (0x0A)
#define ASCII_ENTER     (0x0D)
#define ASCII_SUB       (0x1A)
#define ASCII_ESCAPE    (0x1B)
#define ASCII_ETXCEL    (0x18)
#define ASCII_DELETE    (0x7F)

#define ASCII_COLEN     (':')
//----------------------------------------------------------------------------
#endif // ASCII_H
//----------------------------------------------------------------------------
